LukasOlivier/cocktailmaker/Foto-Videos/20210517_162841.jpg

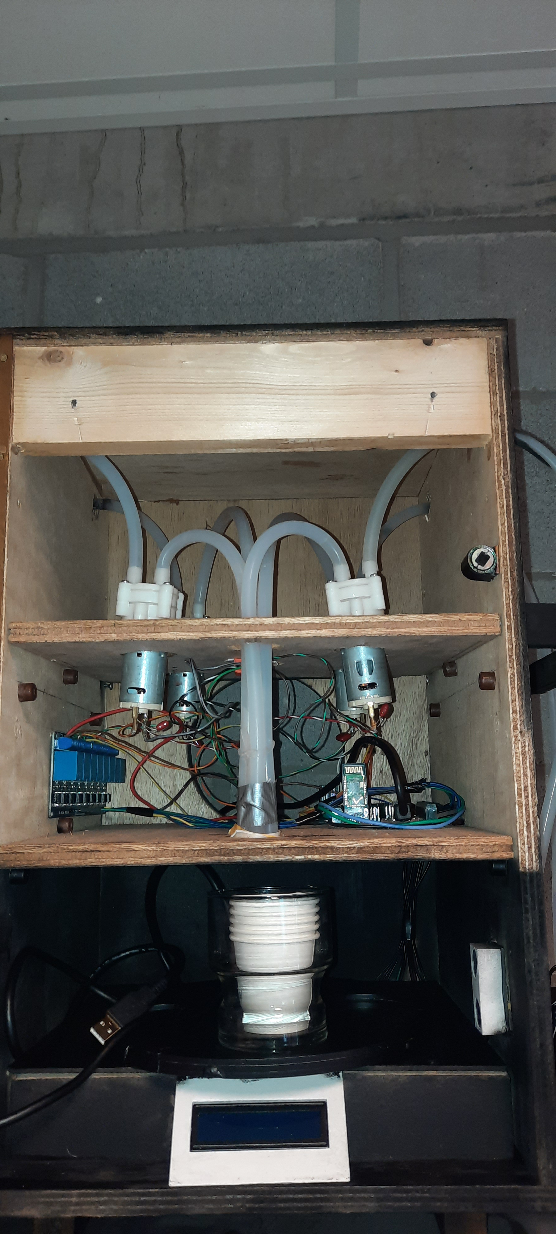
Foto-Videos/20210517_162841.jpg
