LukasOlivier/cocktailmaker/Foto-Videos/App Screenshots/Screenshot_20210322-152155.jpg

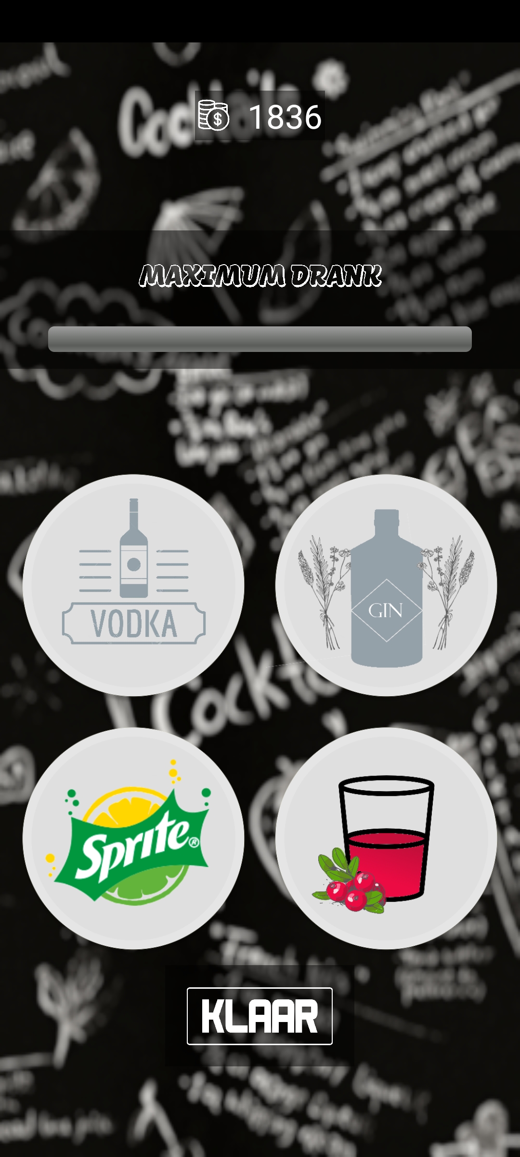
Foto-Videos/App Screenshots/Screenshot_20210322-152155.jpg
