LukasOlivier/cocktailmaker/Foto-Videos/20210106_102020.jpg

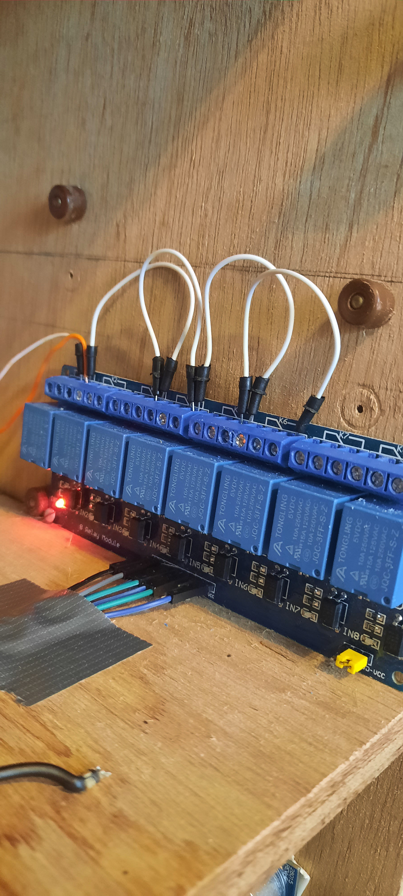
Foto-Videos/20210106_102020.jpg
