LukasOlivier/cocktailmaker/Foto-Videos/20210106_102627.jpg

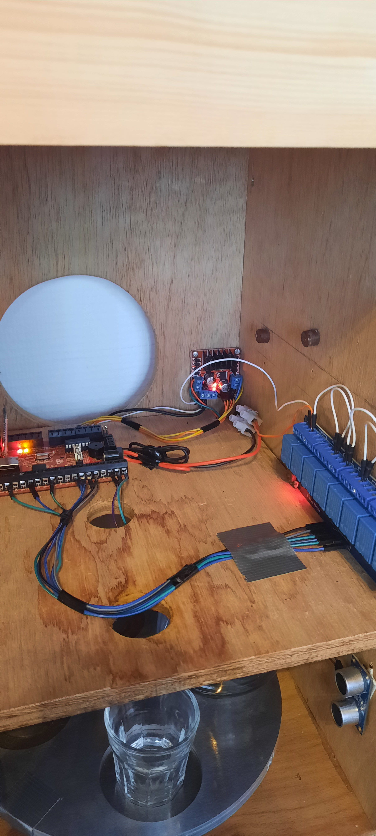
Foto-Videos/20210106_102627.jpg
