LukasOlivier/cocktailmaker/Foto-Videos/20210106_102631.jpg

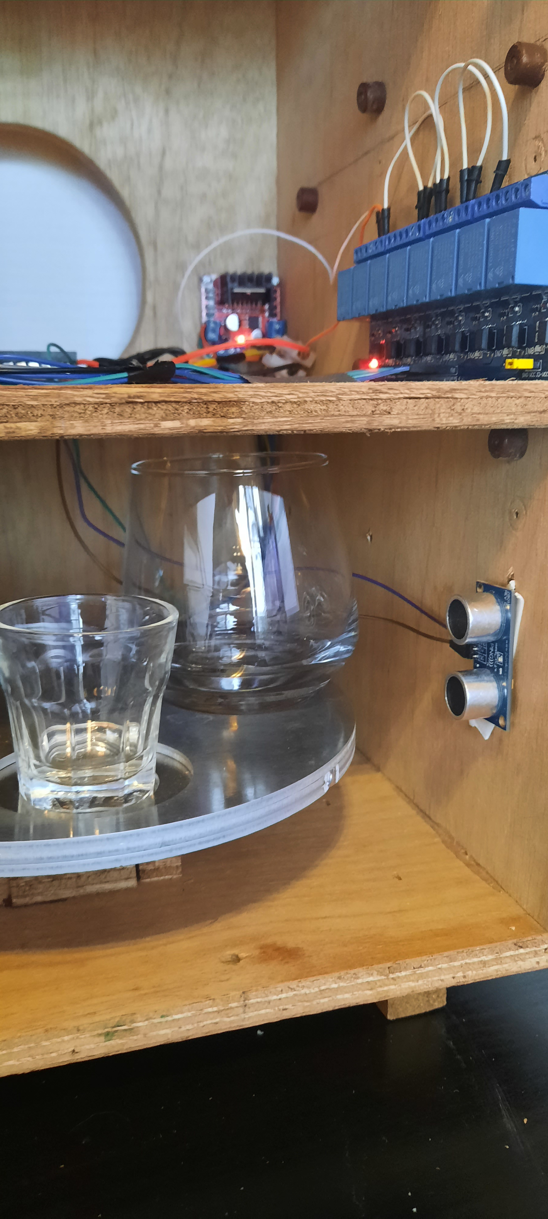
Foto-Videos/20210106_102631.jpg
