LukasOlivier/cocktailmaker/Foto-Videos/20210106_102637.jpg

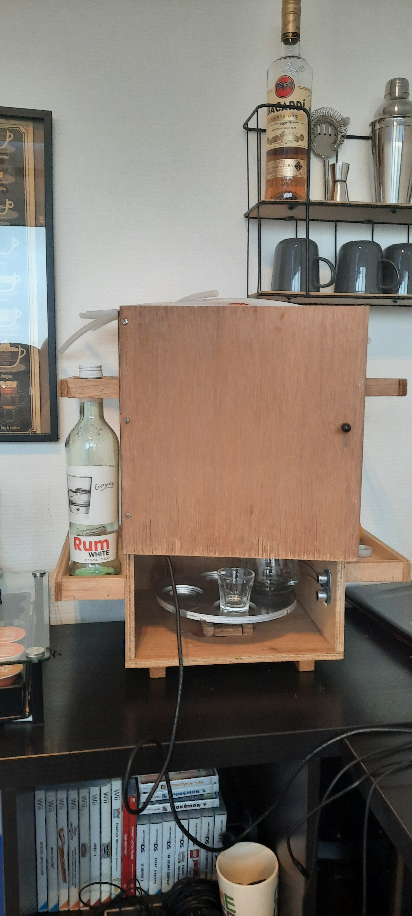
Foto-Videos/20210106_102637.jpg
