LukasOlivier/cocktailmaker/Foto-Videos/20210125_193803.jpg

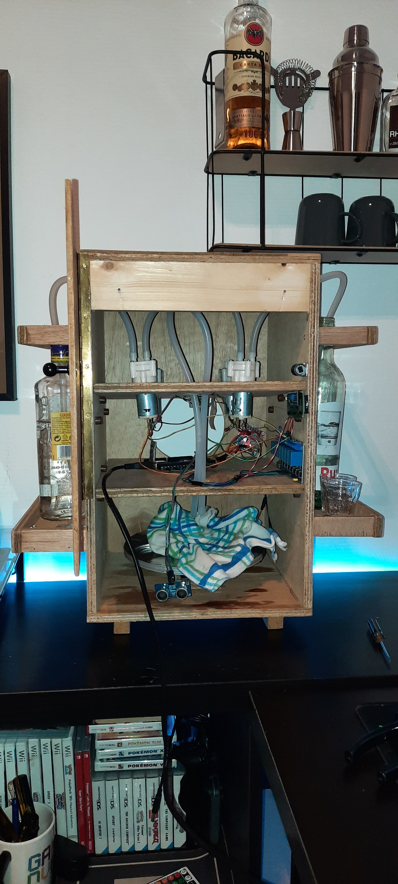
Foto-Videos/20210125_193803.jpg
