LukasOlivier/cocktailmaker/Foto-Videos/20210127_200049.jpg

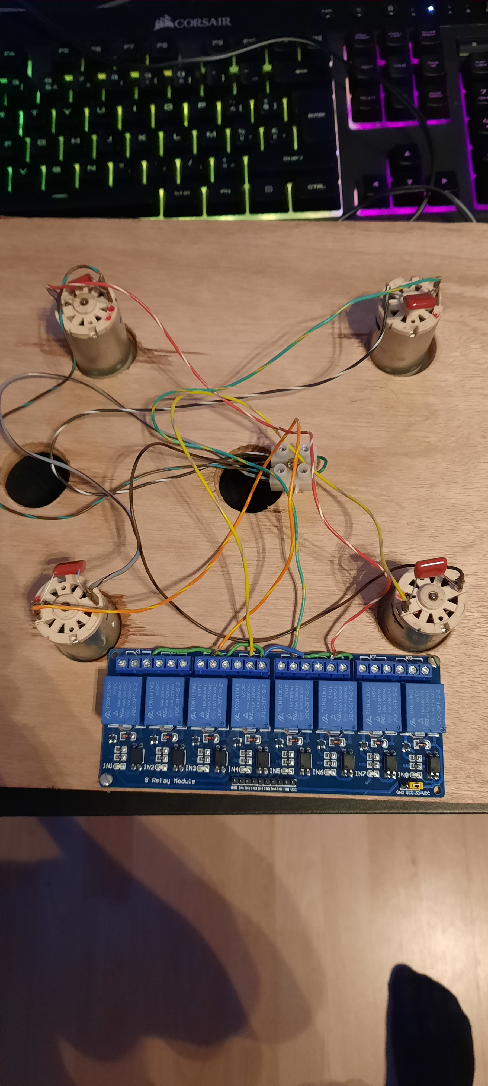
Foto-Videos/20210127_200049.jpg
