LukasOlivier/cocktailmaker/Foto-Videos/20210222_174452.jpg

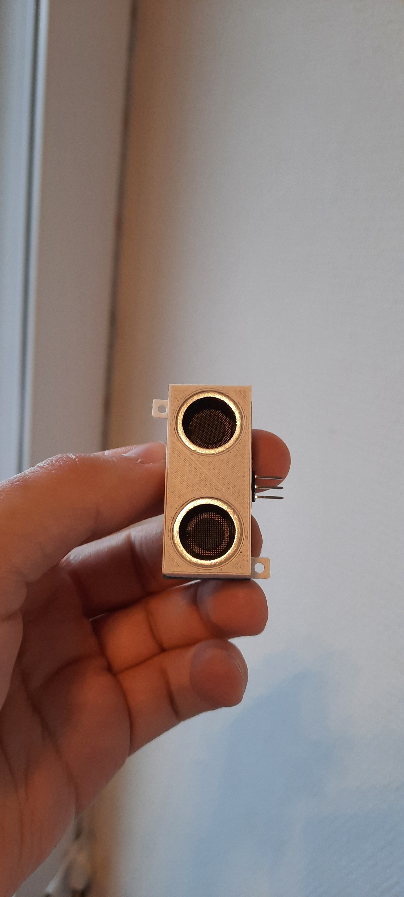
Foto-Videos/20210222_174452.jpg
