LukasOlivier/cocktailmaker/Foto-Videos/20210303_130257.jpg

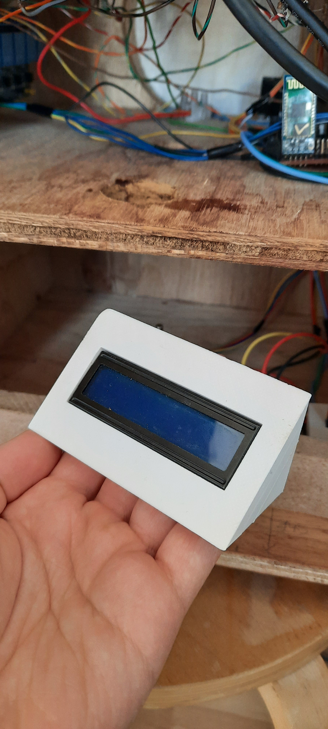
Foto-Videos/20210303_130257.jpg
