LukasOlivier/cocktailmaker/Foto-Videos/20210412_091803.jpg

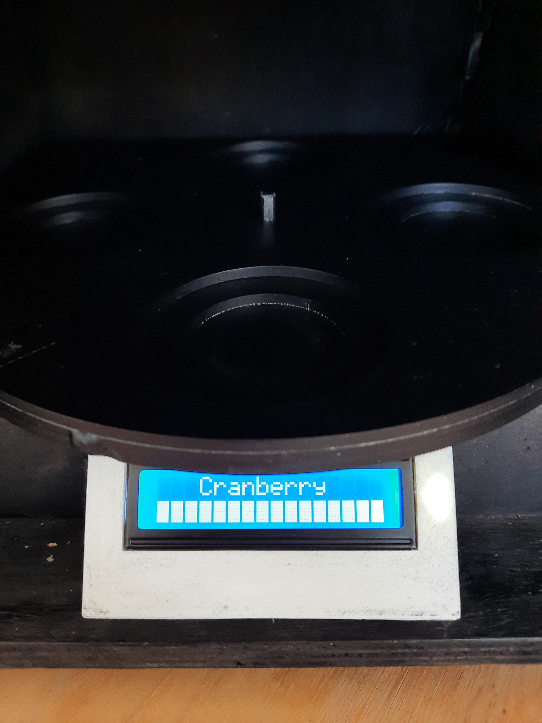
Foto-Videos/20210412_091803.jpg
