LukasOlivier/cocktailmaker/Foto-Videos/20210412_103041.jpg

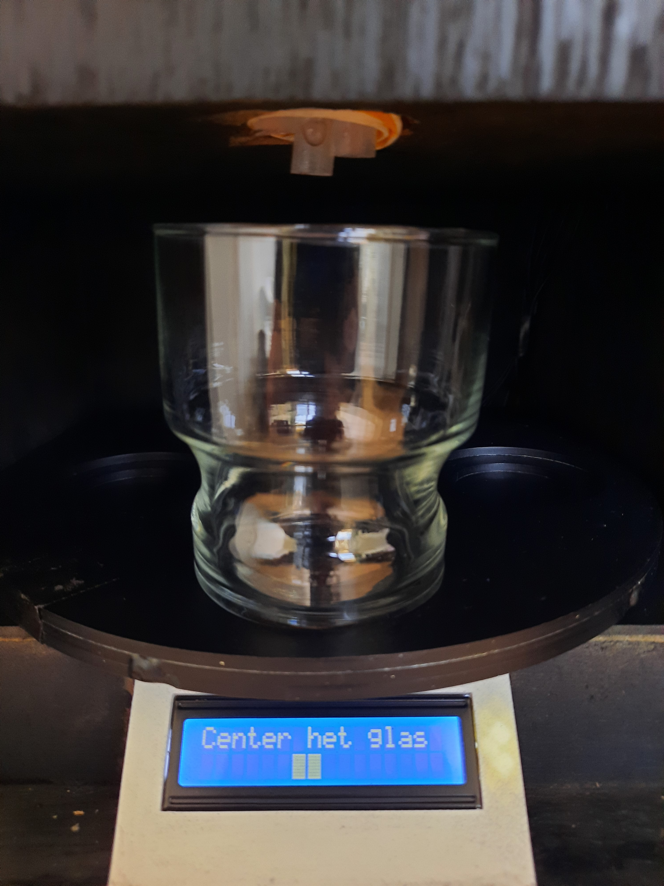
Foto-Videos/20210412_103041.jpg
