LukasOlivier/cocktailmaker/Foto-Videos/20210517_162856.jpg

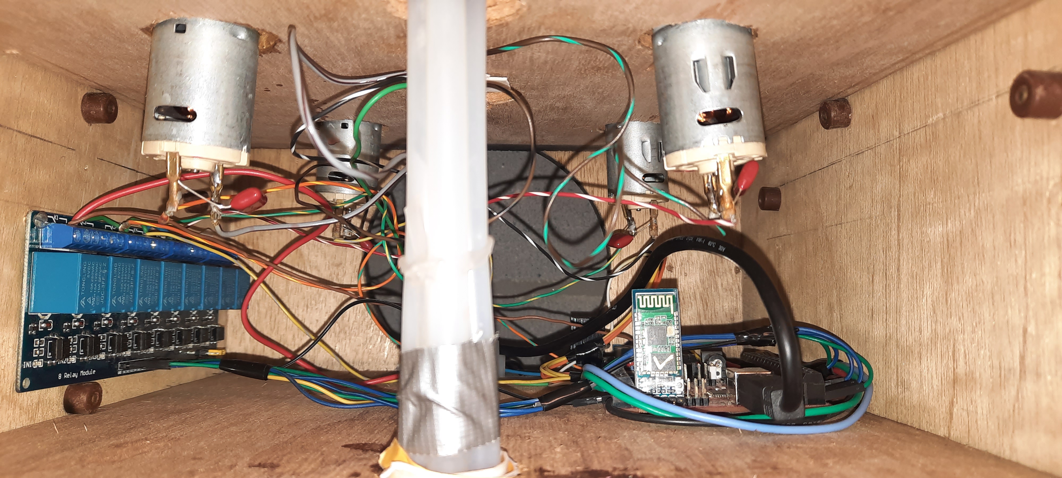
Foto-Videos/20210517_162856.jpg
