LukasOlivier/cocktailmaker/Foto-Videos/20210517_162904.jpg

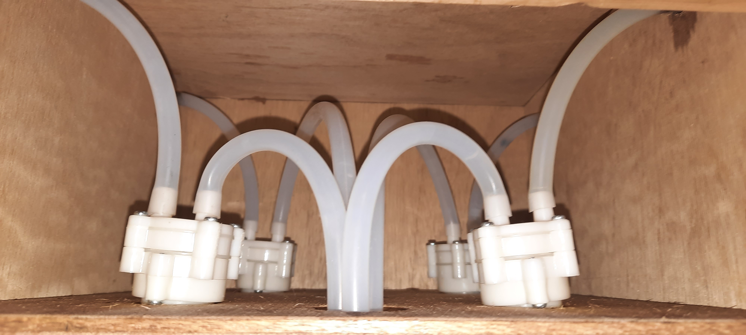
Foto-Videos/20210517_162904.jpg
