LukasOlivier/cocktailmaker/Foto-Videos/App Screenshots/Screenshot_20210222-152931.jpg

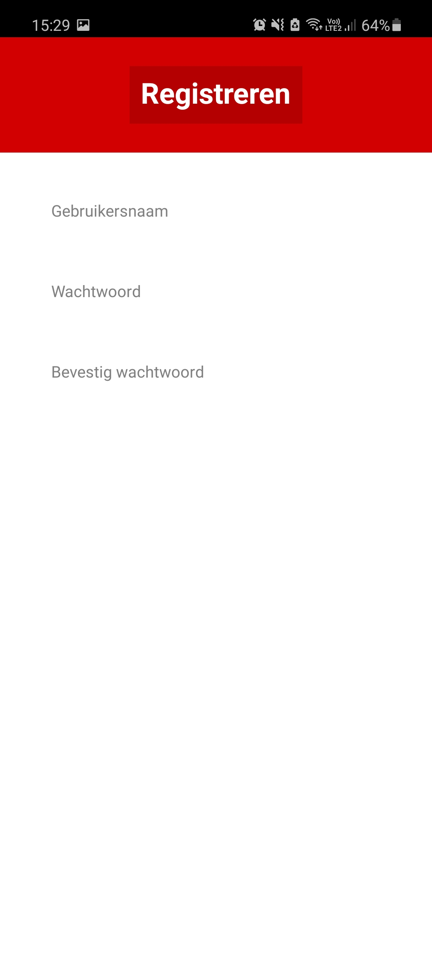
Foto-Videos/App Screenshots/Screenshot_20210222-152931.jpg
