LukasOlivier/cocktailmaker/Foto-Videos/App Screenshots/Screenshot_20210222-153700_Chrome.jpg

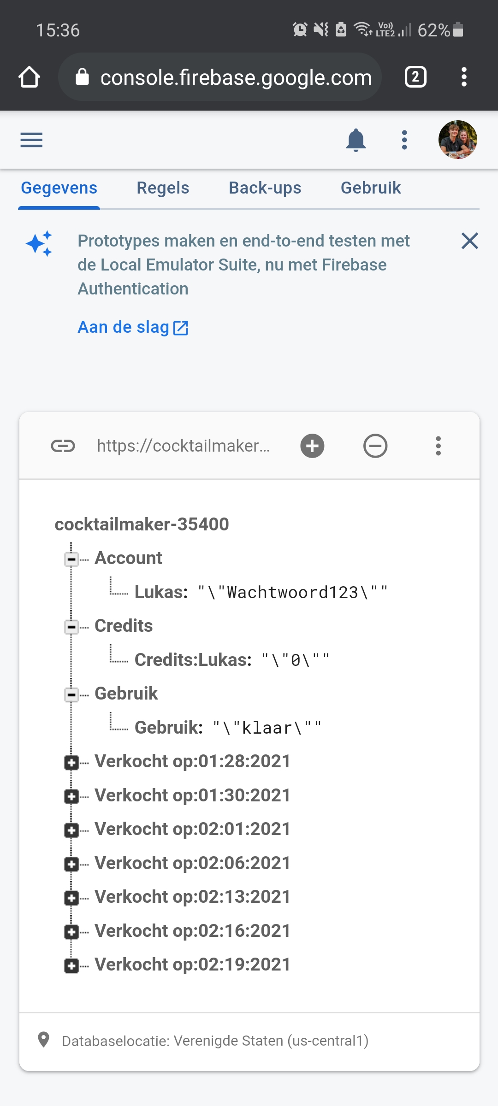
Foto-Videos/App Screenshots/Screenshot_20210222-153700_Chrome.jpg
