LukasOlivier/cocktailmaker/Foto-Videos/App Screenshots/Screenshot_20210222-153733_Chrome.jpg

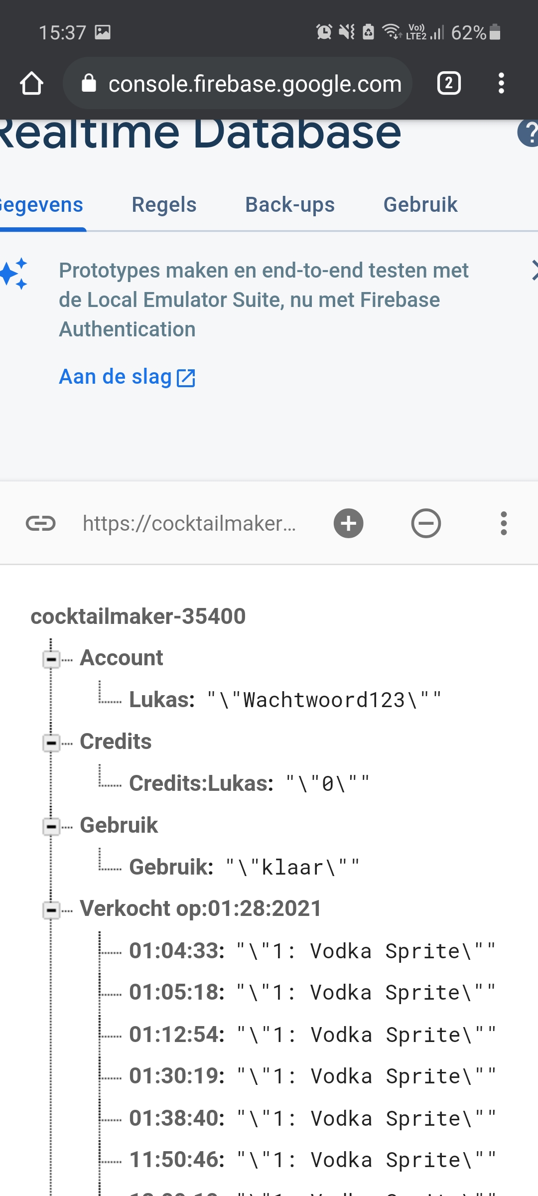
Foto-Videos/App Screenshots/Screenshot_20210222-153733_Chrome.jpg
