LukasOlivier/cocktailmaker/Foto-Videos/App Screenshots/Screenshot_20210222-161957.jpg

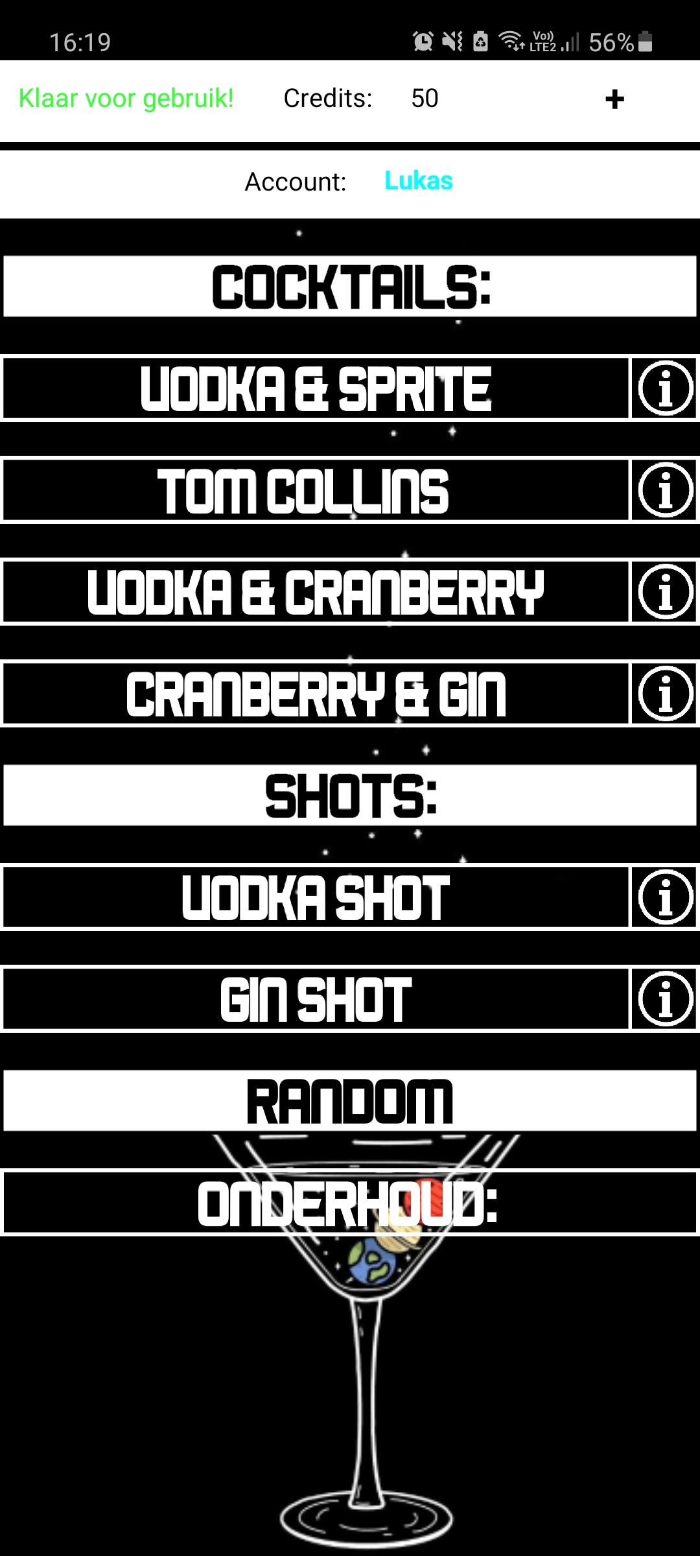
Foto-Videos/App Screenshots/Screenshot_20210222-161957.jpg
