LukasOlivier/cocktailmaker/Foto-Videos/App Screenshots/Screenshot_20210224-095050.jpg

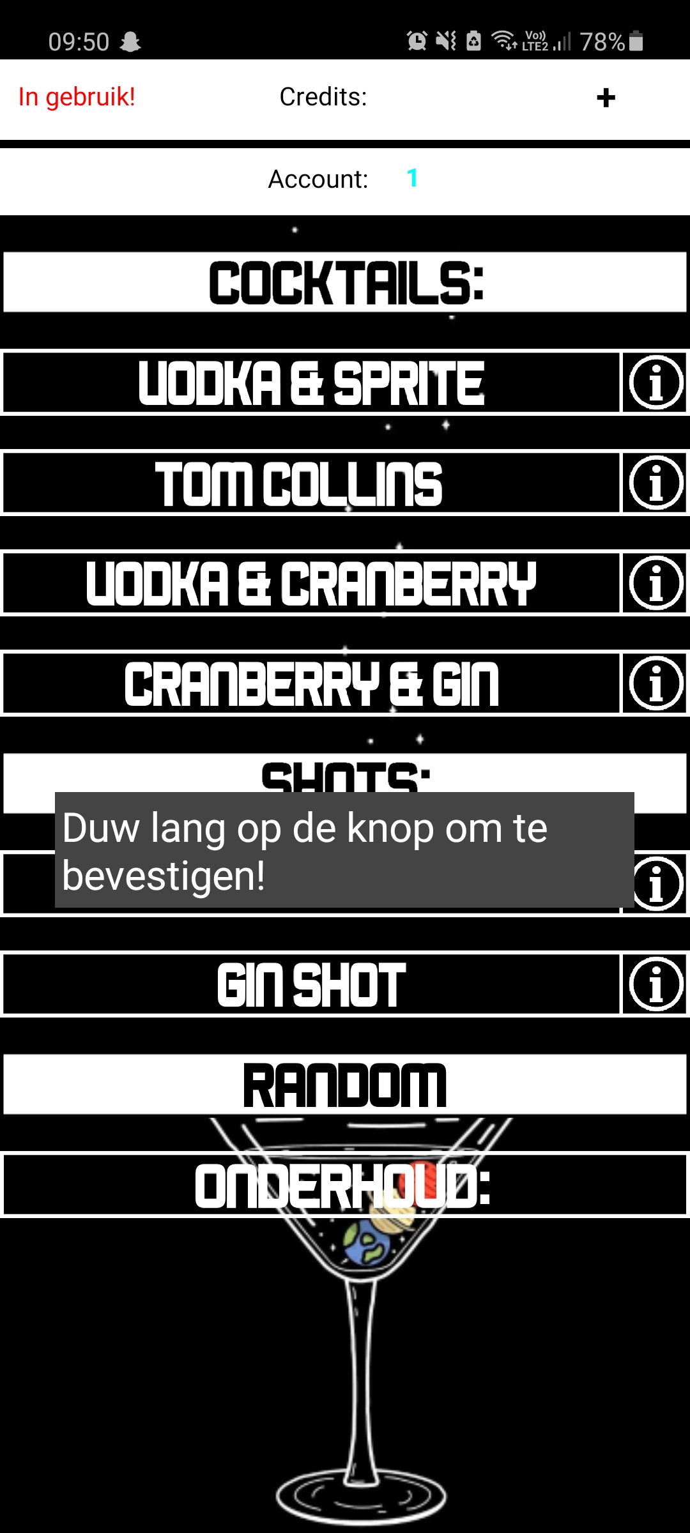
Foto-Videos/App Screenshots/Screenshot_20210224-095050.jpg
