LukasOlivier/cocktailmaker/Foto-Videos/App Screenshots/Screenshot_20210322-152454.jpg

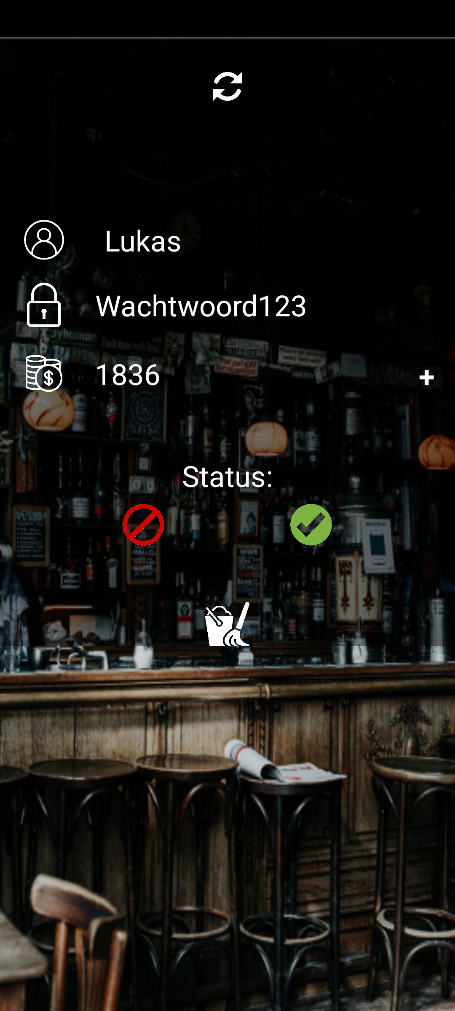
Foto-Videos/App Screenshots/Screenshot_20210322-152454.jpg
