LukasOlivier/cocktailmaker/Foto-Videos/App Screenshots/Screenshot_20210420-185631.jpg

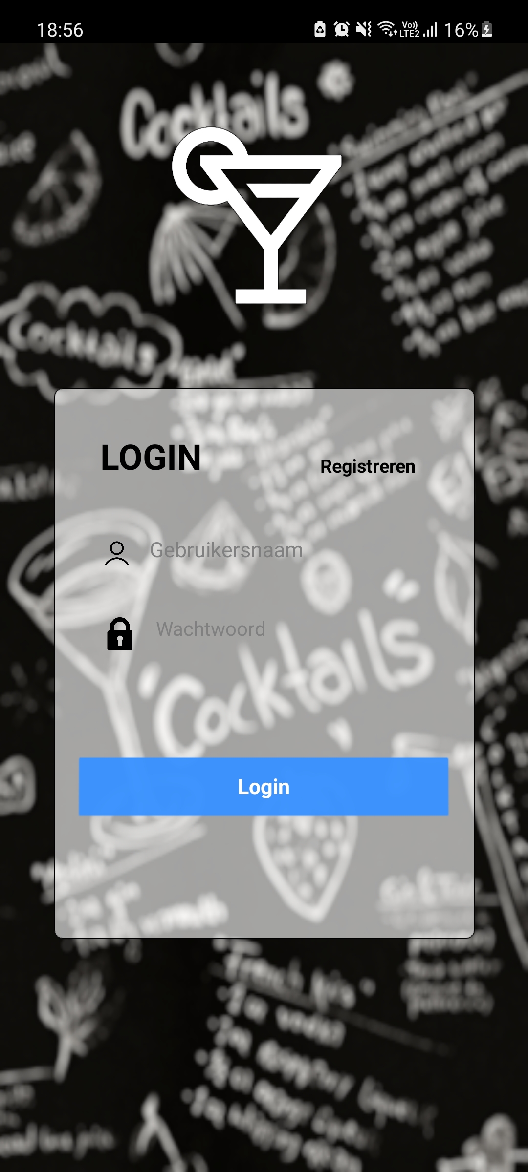
Foto-Videos/App Screenshots/Screenshot_20210420-185631.jpg
