LukasOlivier/cocktailmaker/Foto-Videos/App Screenshots/Screenshot_20210420-185639.jpg

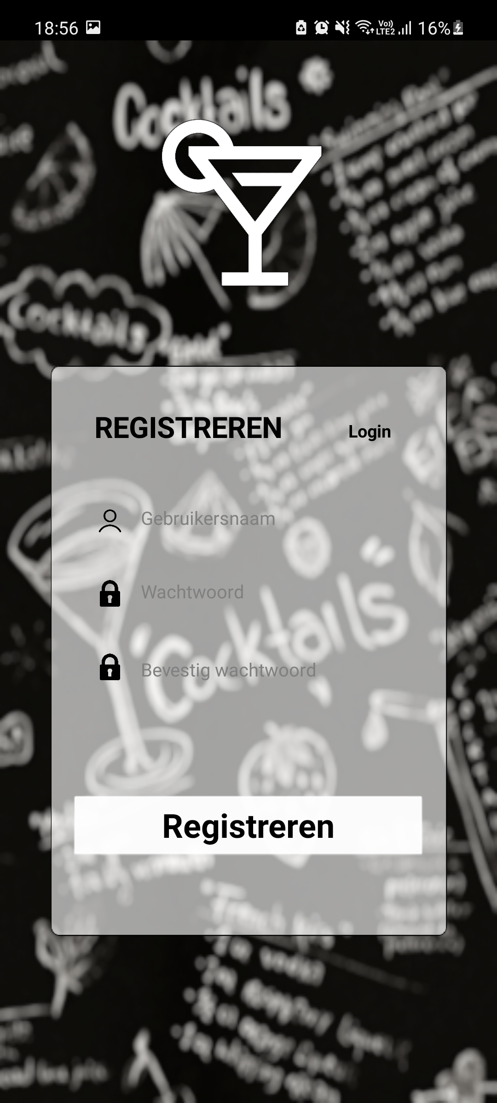
Foto-Videos/App Screenshots/Screenshot_20210420-185639.jpg
