LukasOlivier/cocktailmaker/Foto-Videos/Draaitafel.jpg

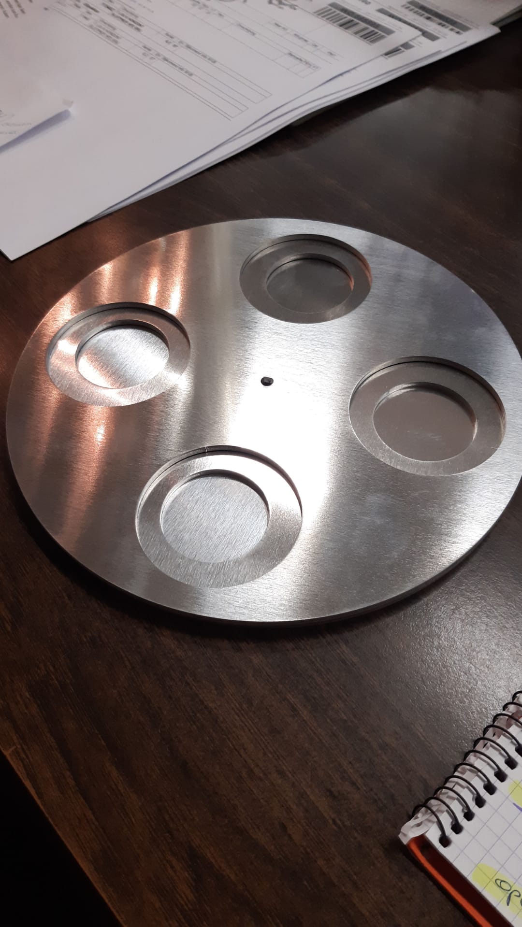
Foto-Videos/Draaitafel.jpg
