LukasOlivier/cocktailmaker/Solid Edge/Case 3D.PNG

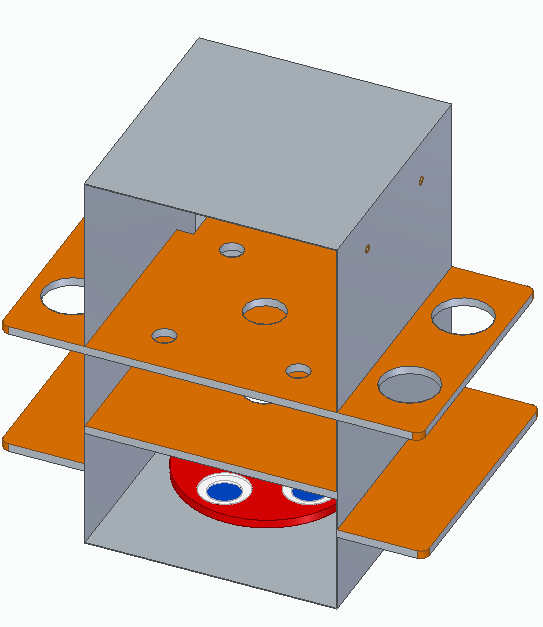
Solid Edge/Case 3D.PNG
