LukasOlivier/cocktailmaker/Solid Edge/Case.PNG

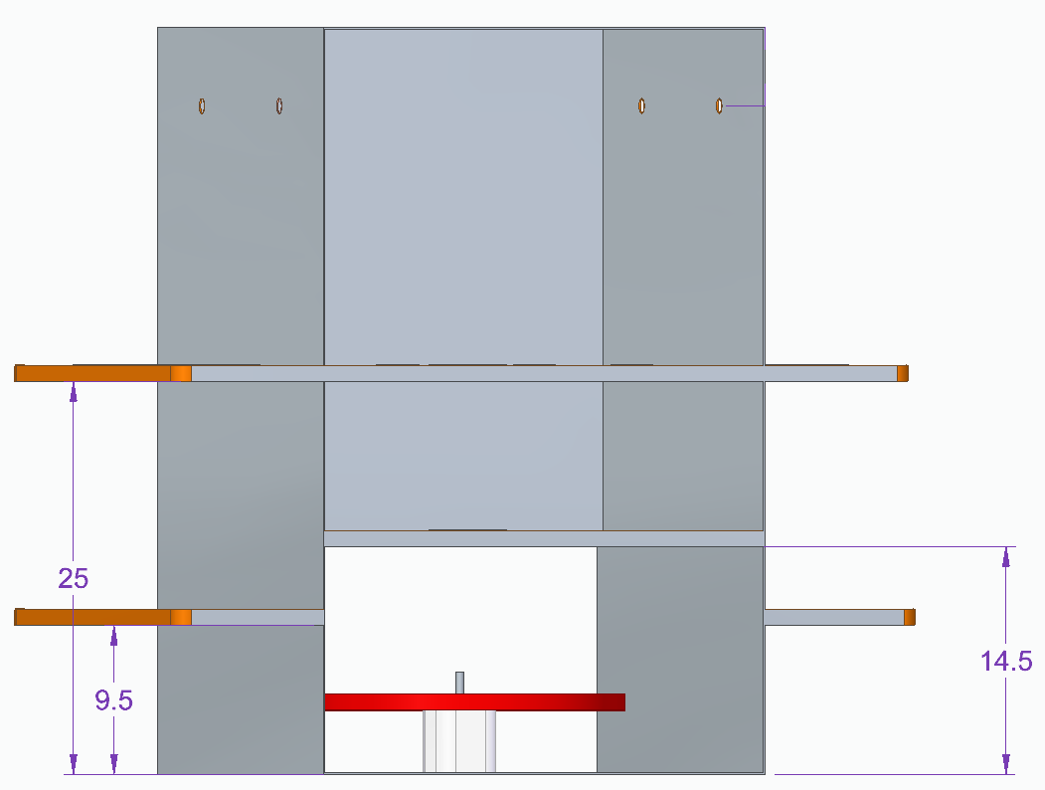
Solid Edge/Case.PNG
