LukasOlivier/cocktailmaker/Solid Edge/Cirkel 3D.PNG

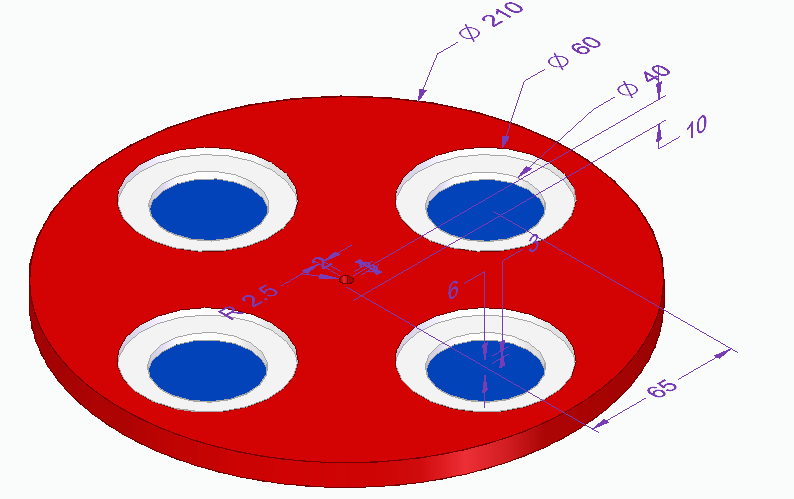
Solid Edge/Cirkel 3D.PNG
