LukasOlivier/cocktailmaker/Solid Edge/Cirkel Boven.PNG

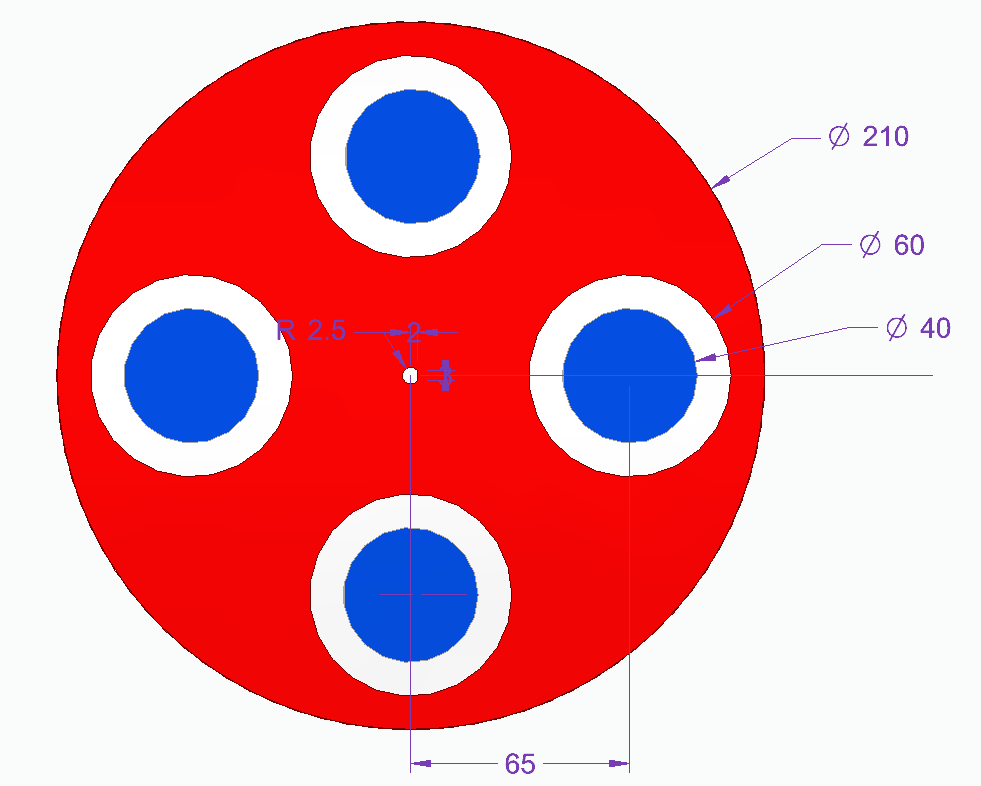
Solid Edge/Cirkel Boven.PNG
