LukasOlivier/cocktailmaker/Solid Edge/Cirkel Zijkant.PNG

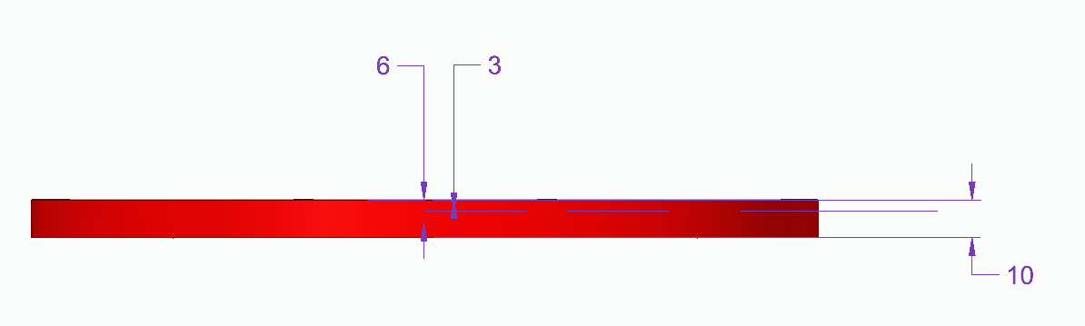
Solid Edge/Cirkel Zijkant.PNG
